RayyanRafikh/Comparative-Implementation-of-SLAM-on-Mobile-Robotic-Platforms-using-Ultrasonic-and-LiDAR-Sensors/README.md

# Comparative-Implementation-of-SLAM-on-Mobile-Robotic-Platforms-using-Ultrasonic-and-LiDAR-Sensors

Read through the report to understand the project.
